seb303/Arduino-XP-BMS/hardware/Final-2.jpg

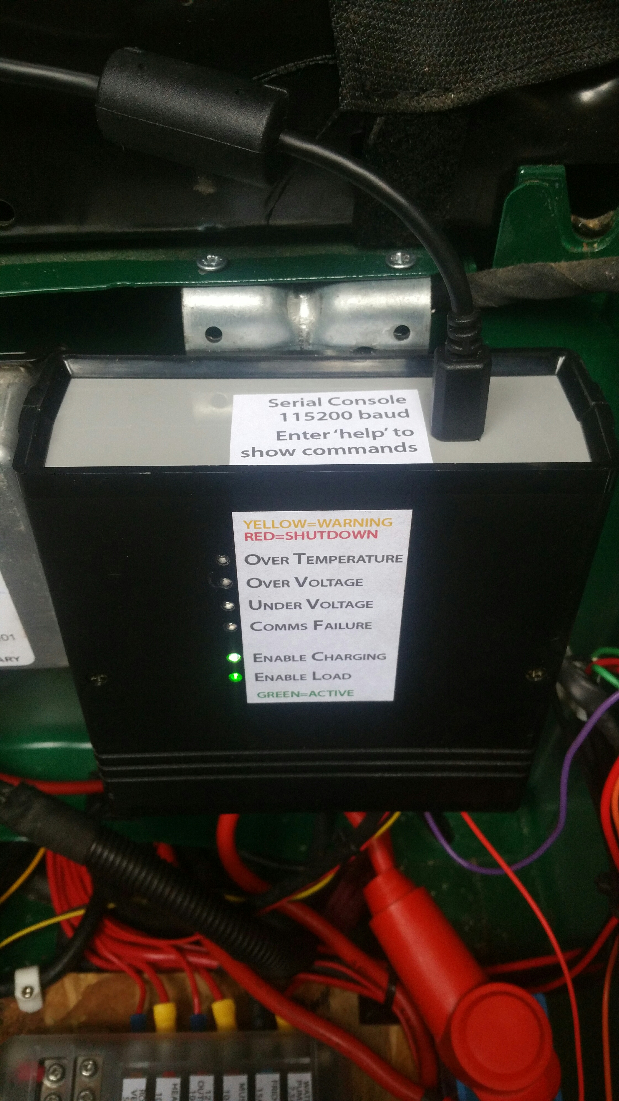
hardware/Final-2.jpg
