seb303/Arduino-XP-BMS/hardware/Final-1.jpg

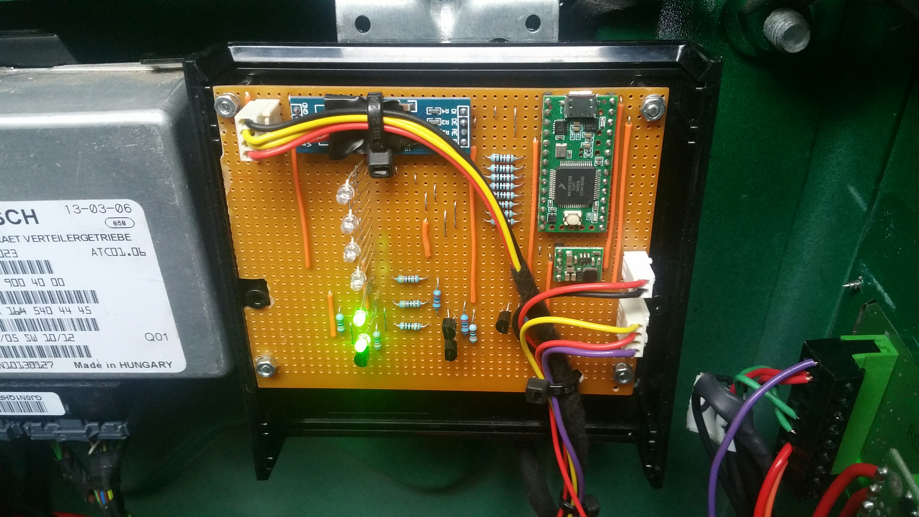
hardware/Final-1.jpg
