seb303/Arduino-XP-BMS/hardware/Prototype.jpg

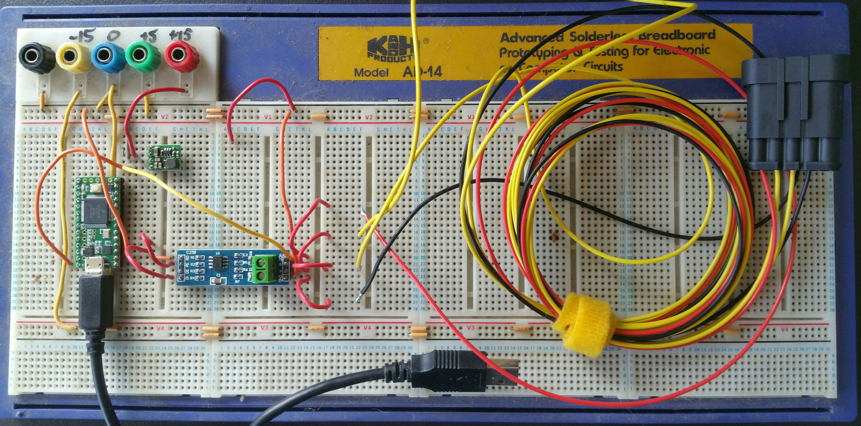
hardware/Prototype.jpg
