seb303/Arduino-XP-BMS/hardware/Arduino-XP-BMS-stripboard-layout.pdf

O O

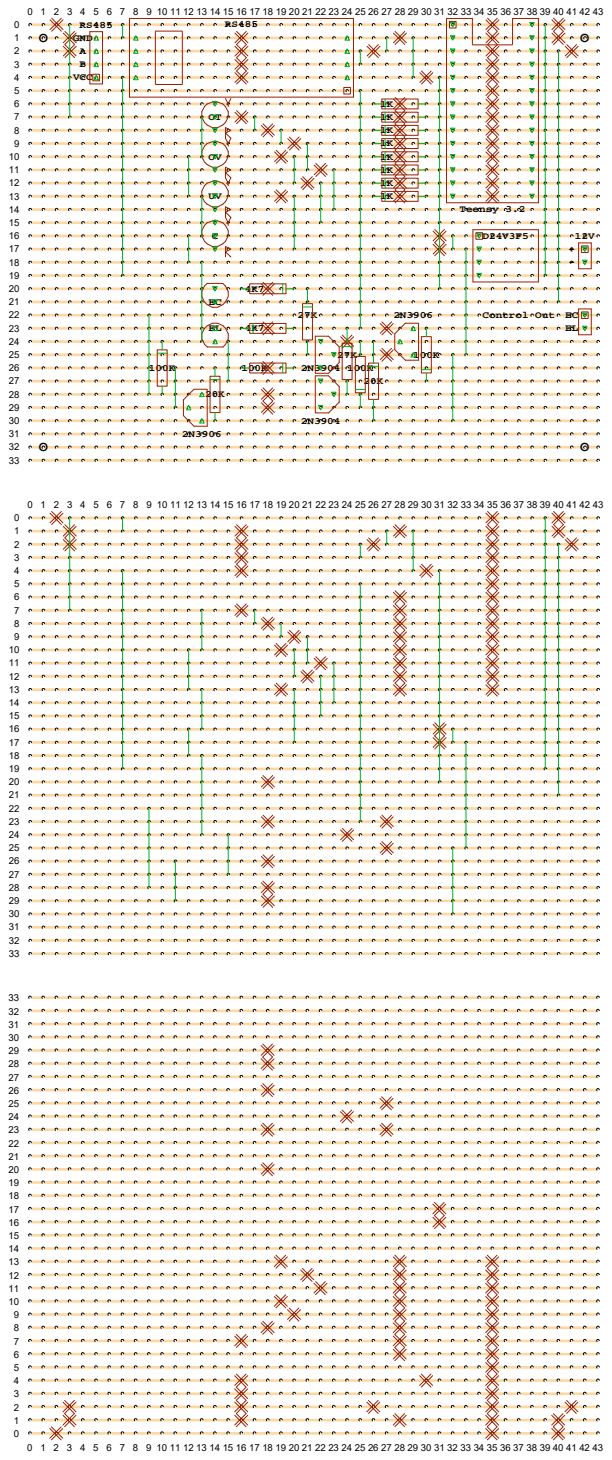
[picture p5: page 1]
GND; VCC; Control Out; Teensy 3.2
