seb303/Arduino-XP-BMS/hardware/with-EL-switch/Arduino-XP-BMS-schematic.pdf

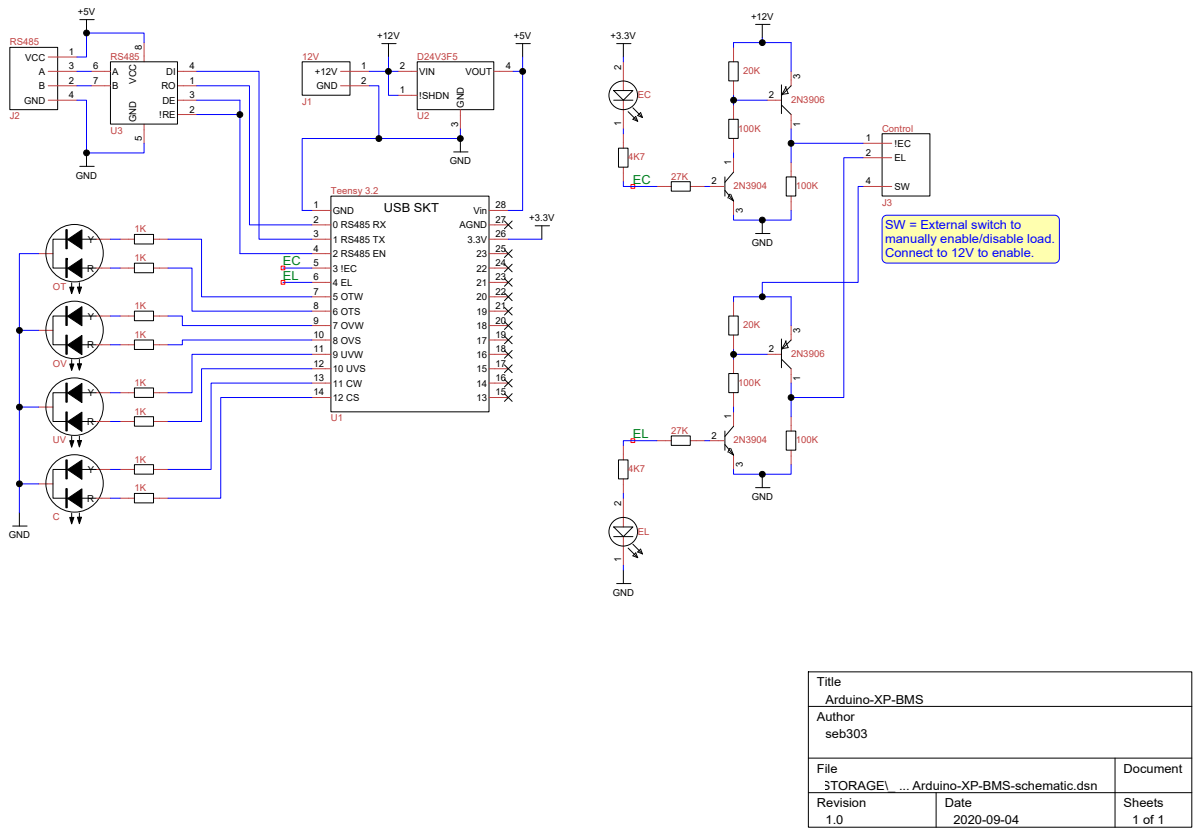
[picture p6: page 1]
GND 1 0 RS485 RX 2 1 RS485 TX 3 2 RS485 EN 4 3 !EC 5 4 EL 6 5 OTW 7 6 OTS 8 7 OVW 9 8 OVS 10 9 UVW 11 10 UVS 12 11 CW 13; AGND; Vin USB SKT; Teensy 3.2; VIN 2; GND 3; VOUT; !SHDN 1; GND; GND 5 VCC 8; VCC; Control; Title; Author; Document; Date; Sheets; Arduino-XP-BMS; seb303

SW = External switch to
manually enable/disable load.
Connect to 12V to enable.

File
STORAGE\_ ... Arduino-XP-BMS-schematic.dsn
Revision
