seb303/Arduino-XP-BMS/(list of files, drawings)

Other design files:
hardware/Arduino-XP-BMS-schematic.dsn
hardware/Arduino-XP-BMS.dsn
hardware/with-EL-switch/Arduino-XP-BMS-schematic.dsn
