seb303/Arduino-XP-BMS/(commit log)

2020-09-01 Fixed buffer overflow bug in some strings
    [Arduino-XP-BMS.ino]
2020-09-02 Now reads current. Added new command: debug 2 <n>
2020-09-02 Now reads current. Added new command: debug 2 <n>
2020-09-07 Minor update to v1.3 2020-09-07
    Added configuration to invert Enable outputs.
    Shows current time since power on when reading event log
    Adjusted default values for the warning and shutdown thresholds
    [Arduino-XP-BMS.ino]
2020-10-18 v1.6 2020-10-18
    Changed default values for storageMinSOC & storageMaxSOC
    Improved charging logic in storage mode
    Improved formatting of figures in debug output and when reading logs
2020-10-18 v1.6 2020-10-18
    Fix comment
    [Arduino-XP-BMS.ino]
2020-11-16 Fixed bug where PCBA thesholds being ignored
    [Arduino-XP-BMS.ino]
